rabbits-robotics/beta_main_pcb/bom.csv

Reference | Value | Footprint | QUANTITY
CAN1 | Conn_01x02 | Connector_JST:JST_PH_S2B-PH-K_1x02_P2.00mm_Horizontal | 1
DCDCin1 | Conn_01x02 | Connector_AMASS:AMASS_XT30PW-M_1x02_P2.50mm_Horizontal | 1
DCDCout1 | Conn_01x02 | Connector_AMASS:AMASS_XT30PW-F_1x02_P2.50mm_Horizontal | 1
FireLeft1,FireRight1,Load1 | Conn_01x02 | Connector_JST:JST_PH_B2B-PH-K_1x02_P2.00mm_Vertical | 3
FirePower1,FirePower2 | Conn_01x02 | Connector_JST:JST_XH_B2B-XH-A_1x02_P2.50mm_Vertical | 2
MainBoard1 | NUCLEO-F303K8 | User:MODULE_NUCLEO-F303K8 | 1
PitchMotor1 | Conn_01x06 | Connector_JST:JST_PH_B6B-PH-K_1x06_P2.00mm_Vertical | 1
R1 | 120 | Resistor_THT:R_Axial_DIN0204_L3.6mm_D1.6mm_P5.08mm_Horizontal | 1
U1 | ~ | User:DRV8835 | 1
U2 | MCP2562-E-P | Package_DIP:DIP-8_W7.62mm | 1
U3 | ~ | User:BNO055 | 1
Vin1,YawMotor1 | Conn_01x06 | Connector_JST:JST_PH_S6B-PH-K_1x06_P2.00mm_Horizontal | 2
