rabbits-robotics/beta_main_pcb/beta_main.step

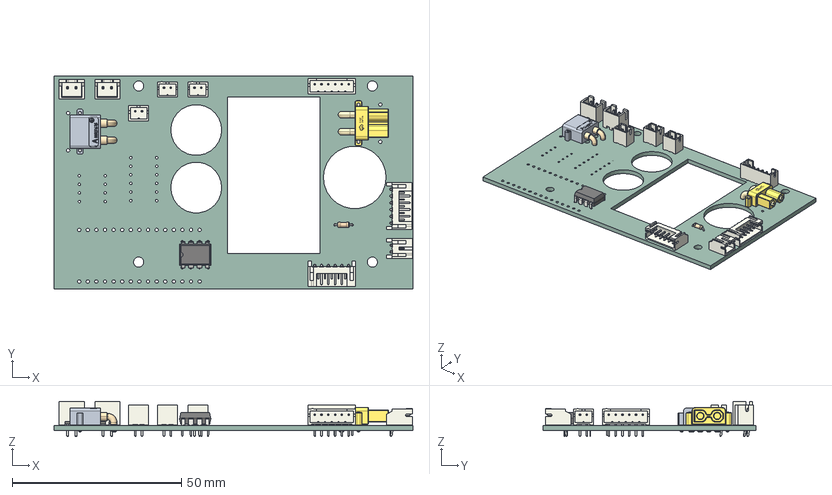
[picture p1: CAD file, 2026-10-18]
beta_main.step
106.0 x 63.0 x 10.4 mm
CONN-TH_XT30PW-M
DIP-8_W7.62mm
JST_B2B_PH_K x 3
JST_S2B_PH_K
JST_B6B_PH_K
JST_S6B_PH_K x 2
JST_B2B_XH_A x 2
CONN-TH_XT30PW-F-1
R_Axial_DIN0204_L36mm_D16mm_P508mm_Horizontal
beta_main_PCB
