rabbits-robotics/beta_main_pcb/beta_main.pdf

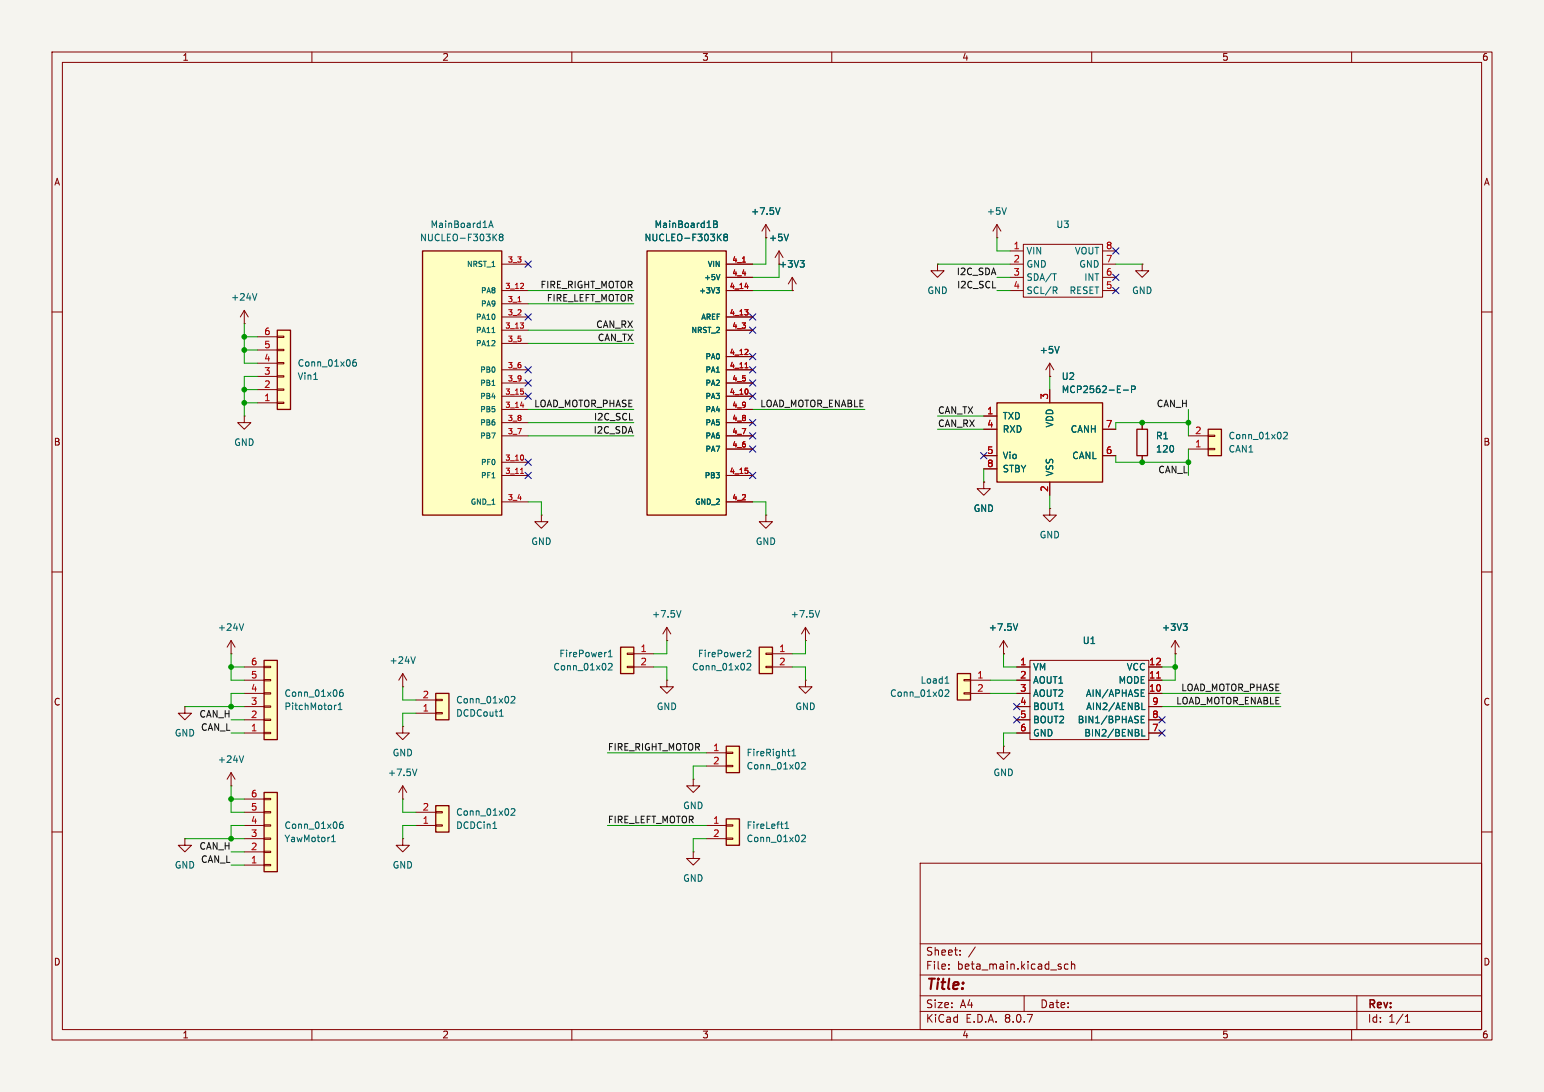
[picture p2: page 1]

3 RXD 4 Vio 5 CANL 6 CANH 7 STBY 8 U2 MCP2562-E-P

3 RXD 4 Vio 5 CANL 6 CANH 7 STBY 8 R1

Id: 1/1 Title: File: beta_main.kicad_sch Sheet: /
