rabbits-robotics/beta_main_pcb/beta_main.kicad_pcb

## KiCad design beta_main.kicad_pcb (2026-10-18)

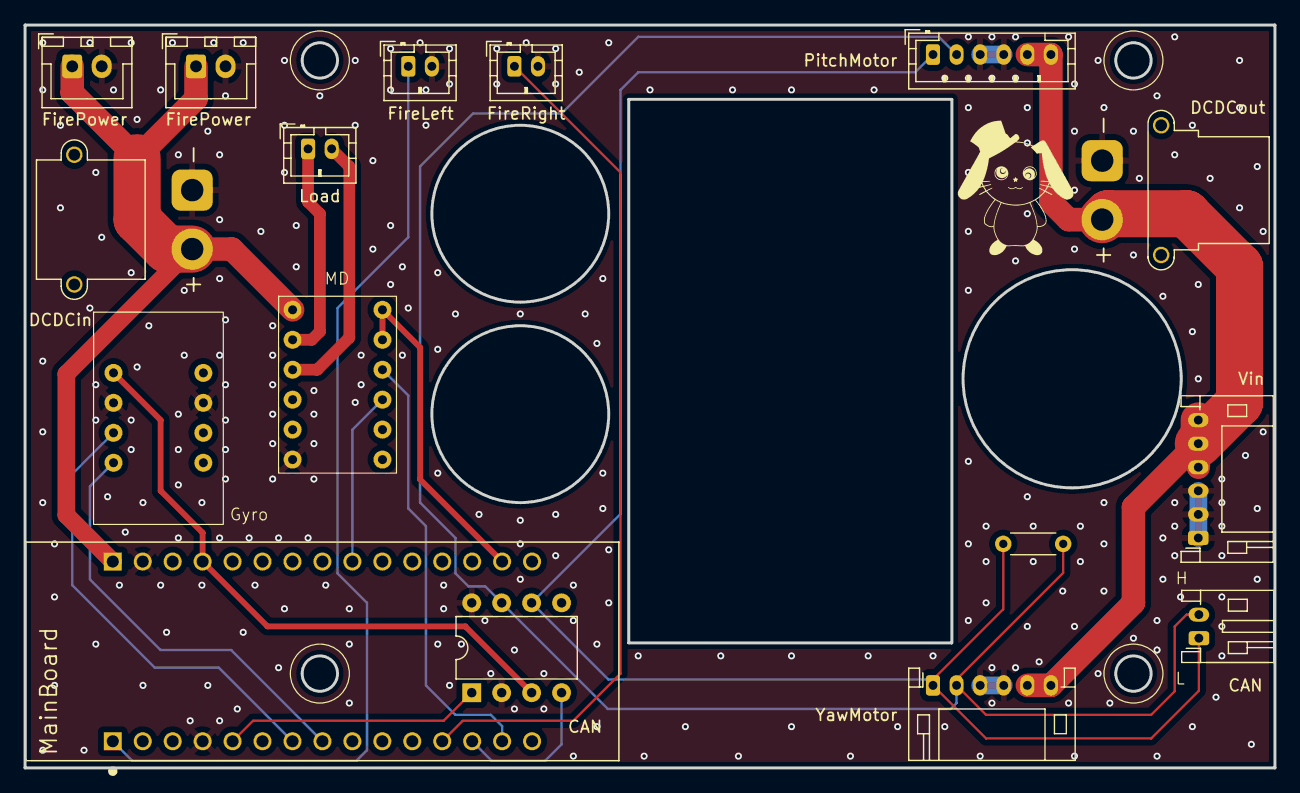
[picture p3: board beta_main.kicad_pcb from above]

Board: 2 copper layers, 106.0 x 63.0 mm, 16 parts (0 on the bottom side), 17 nets.

Parts:
CAN: MCP2562-E-P; DIP-8_W7.62mm
CAN#2: Conn_01x02; JST_PH_S2B-PH-K_1x02_P2.00mm_Horizontal
DCDCin: Conn_01x02; AMASS_XT30PW-M_1x02_P2.50mm_Horizontal
DCDCout: Conn_01x02; AMASS_XT30PW-F_1x02_P2.50mm_Horizontal
FireLeft: Conn_01x02; JST_PH_B2B-PH-K_1x02_P2.00mm_Vertical
FirePower: Conn_01x02; JST_XH_B2B-XH-A_1x02_P2.50mm_Vertical
FirePower#2: Conn_01x02; JST_XH_B2B-XH-A_1x02_P2.50mm_Vertical
FireRight: Conn_01x02; JST_PH_B2B-PH-K_1x02_P2.00mm_Vertical
Gyro: BNO055
Load: Conn_01x02; JST_PH_B2B-PH-K_1x02_P2.00mm_Vertical
MD: DRV8835
MainBoard: NUCLEO-F303K8; MODULE_NUCLEO-F303K8
PitchMotor: Conn_01x06; JST_PH_B6B-PH-K_1x06_P2.00mm_Vertical
R1: 120; R_Axial_DIN0204_L3.6mm_D1.6mm_P5.08mm_Horizontal
Vin: Conn_01x06; JST_PH_S6B-PH-K_1x06_P2.00mm_Horizontal
YawMotor: Conn_01x06; JST_PH_S6B-PH-K_1x06_P2.00mm_Horizontal

Connections:
+3V3: MD.11 (MODE), MD.12 (VCC), MainBoard.4_14 (+3V3)
+5V: CAN.3 (VDD), Gyro.1 (VIN), MainBoard.4_4 (+5V)
+7.5V: DCDCin.2, FirePower.1, FirePower#2.1, MD.1 (VM), MainBoard.4_1 (VIN)
+24V: DCDCout.2, PitchMotor.5, PitchMotor.6, Vin.4, Vin.5, Vin.6, YawMotor.5, YawMotor.6
/CAN_H: CAN.7 (CANH), CAN#2.2, PitchMotor.2, R1.1, YawMotor.2
/CAN_L: CAN.6 (CANL), CAN#2.1, PitchMotor.1, R1.2, YawMotor.1
/CAN_RX: CAN.4 (RXD), MainBoard.3_13 (PA11)
/CAN_TX: CAN.1 (TXD), MainBoard.3_5 (PA12)
/FIRE_LEFT_MOTOR: FireLeft.1, MainBoard.3_1 (PA9)
/FIRE_RIGHT_MOTOR: FireRight.1, MainBoard.3_12 (PA8)
/I2C_SCL: Gyro.4 (SCL/R), MainBoard.3_8 (PB6)
/I2C_SDA: Gyro.3 (SDA/T), MainBoard.3_7 (PB7)
/LOAD_MOTOR_ENABLE: MD.9 (AIN2/AENBL), MainBoard.4_9 (PA4)
/LOAD_MOTOR_PHASE: MD.10 (AIN/APHASE), MainBoard.3_14 (PB5)
GND: CAN.2 (VSS), CAN.8 (STBY), DCDCin.1, DCDCout.1, FireLeft.2, FirePower.2, FirePower#2.2, FireRight.2, Gyro.2 (GND), Gyro.7 (GND), MD.6 (GND), MainBoard.3_4 (GND_1), MainBoard.4_2 (GND_2), PitchMotor.3, PitchMotor.4, Vin.1, Vin.2, Vin.3, YawMotor.3, YawMotor.4
unnamed: Load.1, MD.2 (AOUT1)
unnamed: Load.2, MD.3 (AOUT2)
